Idontwanastudy/-stm32-MP3-FLAC-WAV-/Hardware/hifimp3 BOM/BOM_主板_PCB1_2026-09-06.xlsx

No. | Quantity | Comment | Designator | Footprint | Value | Manufacturer Part | Manufacturer | Supplier Part | Supplier
1 | 2 | 100nF | C10,C17 | C0603 |  | CC0603KRX7R9BB104 | YAGEO | C14663 | LCSC
2 | 1 | 8.2nF | C12 | C0603 |  | CL10B822KB8NNNC | SAMSUNG | C27920 | LCSC
3 | 1 | 1.2nF | C14 | C0603 |  | FN18X122K500PSG | PSA(Prosperity Dielectrics) | C565591 | LCSC
4 | 1 | 10pF | C15 | C0603 |  | CC0603JRNPO9BN100 | YAGEO | C106245 | LCSC
5 | 2 | 100nF | C24,C26 | C0805__ |  | CC0603KRX7R9BB104 | YAGEO | C14663 | LCSC
6 | 2 | 22uF | C27,C28 | C0805__ |  | CL10A226MQ8NRNC | SAMSUNG | C59461 | LCSC
7 | 2 | 47uF | C38,C39 | C0805 | 47uF | CGA0805X5R476M100MT | HRE(芯声) | C6119904 | LCSC
8 | 2 | 4.7uF | C40,C41 | C0805 | 4.7uF | CGA0805X7R475K350MT | HRE(芯声) | C6119943 | LCSC
9 | 6 | 100nF | C44,C45,C77,C92,C100,C101 | C0603 | 100nF | FCC0603B104K500CT | FOJAN(富捷) | C5137636 | LCSC
10 | 2 | 5.6pF | C46,C53 | C0603 | 5.6pF | CC0603CRNPO9BN5R6 | YAGEO(国巨) | C309464 | LCSC
11 | 2 | 220nF | C52,C65 | C0603 | 220nF | CC0603KRX7R9BB224 | YAGEO(国巨) | C107083 | LCSC
12 | 1 | 10nF | C54 | C0603 | 10nF | FCC0603B103K500CT | FOJAN(富捷) | C5137477 | LCSC
13 | 1 | 4.7nF | C55 | C0603 | 4.7nF | 0603B472K500NT | FH(风华) | C53987 | LCSC
14 | 10 | 10uF | C61,C62,C63,C64,C67,C78,C79,C93,C94,C95 | C0805 | 10uF | CGA0805X5R106K500MT | HRE(芯声) | C6119889 | LCSC
15 | 1 | 1.5nF | C66 | C0603 | 1.5nF | CC0603KRX7R9BB152 | YAGEO(国巨) | C96090 | LCSC
16 | 8 | 4.7uF | C80,C81,C82,C83,C84,C85,C86,C87 | C1206 | 4.7uF | HHV1206R7475K101NSPJ | Chinocera(华瓷) | C22367839 | LCSC
17 | 2 | 100nF | C88,C89 | C0805 | 100nF | CC0805KRX7R9BB104 | YAGEO(国巨) | C49678 | LCSC
18 | 2 | 4.7uF | C90,C91 | C0805 | 4.7uF | HGC0805R7475K500NSLJ | Chinocera(华瓷) | C7472970 | LCSC
19 | 2 | 47uF | C96,C97 | CAP-SMD_BD6.3-L6.6-W6.6-LS7.3-FD | 47uF | MA35V47M6X6 | JIERR(捷而瑞) | C46550468 | LCSC
20 | 2 | 220pF | C98,C99 | C0603 | 220pF | CC0603JRNPO9BN221 | YAGEO(国巨) | C106210 | LCSC
21 | 1 | LAIL-PHC2.54-3P-01-XH-RT | CN1 | CONN-TH_3P-P2.50_XY-XHB2.54-3A21-R |  | LAIL-PHC2.54-3P-01-XH-RT | 莱联 | C54905897 | LCSC
22 | 1 | PJ-313D | CN2 | AUDIO-SMD_PJ-313D-2 |  | PJ-313D | SHOU HAN(首韩) | C668608 | LCSC
23 | 1 | LAIL-SI-2.54-2X6P-ZC | CN3 | IDC-TH_12P-P2.54-V-M-R2-C6-LS2.54 |  | LAIL-SI-2.54-2X6P-ZC | LAILAN(莱联) | C55118371 | LCSC
24 | 1 | SS36 | D2 | SMA_L4.3-W2.6-LS5.0-FD |  | SS36 | 宏嘉诚 | C7420367 | LCSC
25 | 5 | SS52B | D3,D4,D5,D6,D7 | SMB_L4.6-W3.6-LS5.3-RD |  | SS52B | R+O(宏嘉诚) | C41410781 | LCSC
26 | 1 | DC-005-A200 | DC1 | DC-IN-TH_DC-005-A200 |  | DC-005-A200 | XUNPU(讯普) | C720557 | LCSC
27 | 2 | LAIL-PZ2.54-3P-L | H1,H2 | HDR-TH_3P-P2.54-V-M-1 |  | LAIL-PZ2.54-3P-L | LAILAN(莱联) | C54950604 | LCSC
28 | 3 | LAIL-PZ2.54-1P-L | H3,H4,H5 | HDR-TH_LAIL-PZ2.54-1P-L |  | LAIL-PZ2.54-1P-L | 莱联 | C54950614 | LCSC
29 | 1 | LAIL-PZ2.54-4PX2-L | H6 | HDR-TH_LAIL-PZ2.54-4PX2-L |  | LAIL-PZ2.54-4PX2-L | 莱联 | C54950608 | LCSC
30 | 1 | LAIL-PZ2.54-2PX2-L | H7 | HDR-TH_LAIL-PZ2.54-2PX2-L |  | LAIL-PZ2.54-2PX2-L | 莱联 | C54950613 | LCSC
31 | 1 | I2S_DEC | H8 | CONN-TH_LAIL-PZ2.54-4P-L |  | I2S_DEC | 莱联 | C54950602 | LCSC
32 | 1 | SPI1_DEC | H9 | CONN-TH_LAIL-PZ2.54-4P-L |  | SPI1_DEC | 莱联 | C54950602 | LCSC
33 | 1 | 6.8uH | L1 | IND-SMD_L5.0-W5.0_SWPA5040S |  | SWPA5040S6R8M | Sunlord | C36411 | LCSC
34 | 2 | 4.7uH | L2,L3 | IND-SMD_L5.4-W5.2_FXL0530 | 4.7uH | FXL0530-4R7-M | cjiang(长江微电) | C177246 | LCSC
35 | 2 | 10uH | L4,L5 | L1206 | 10uH | CMI321609X100KT | FH(风华) | C1051 | LCSC
36 | 1 | 17-21SUYC/TR8 | LED1 | LED0805-RD |  | 17-21SUYC/TR8 | KENTO | C2296 | LCSC
37 | 1 | LTST-C190KSKT GREEN | LED2 | LED0603-RD |  | LTST-C190KSKT GREEN | LITEON(光宝) | C125095 | LCSC
38 | 1 | LTST-C190KSKT RED | LED3 | LED0603-RD |  | LTST-C190KSKT RED | LITEON(光宝) | C125095 | LCSC
39 | 2 | LTST-C190KSKT BLUE | LED4,LED5 | LED0603-RD |  | LTST-C190KSKT BLUE | LITEON(光宝) | C125095 | LCSC
40 | 1 | SI2323DS | Q1 | SOT-23-3_L2.9-W1.3-P1.90-LS2.4-BR |  | SI2323DS | TECH PUBLIC(台舟) | C5182044 | LCSC
41 | 1 | 1K | R3 | R0805 |  | 0805W8F1001T5E | UniOhm | C17513 | LCSC
42 | 1 | 330K | R4 | R0603 |  | 0603WAF3303T5E | UniOhm | C23137 | LCSC
43 | 1 | 68K | R5 | R0603 |  | 0603WAF6802T5E | UniOhm | C23231 | LCSC
44 | 1 | 30K | R6 | R0603 |  | 0603WAF3002T5E | UniOhm | C22984 | LCSC
45 | 1 | 10K | R9 | R0603 |  | 0603WAF1002T5E | UniOhm | C25804 | LCSC
46 | 1 | 1.87K/1.91k | R10 | R0603 |  | 0603WAF1871T5E | UniOhm | C22850 | LCSC
47 | 1 | 100Ω | R11 | R0603 | 100Ω | FRC0603F1000TS | FOJAN(富捷) | C2906981 | LCSC
48 | 13 | 0Ω | R15,R16,R17,R18,R19,R20,R25,R28,R29,R30,R40,R54,R55 | R1206 | 0Ω | RE1206F1R000 | JIERR(捷而瑞) | C46961765 | LCSC
49 | 2 | 130kΩ | R21,R26 | R0603 | 130kΩ | FRC0603F1003TS | FOJAN(富捷) |  | LCSC
50 | 1 | 1MΩ | R23 | R0603 | 1MΩ | FRC0603F1004TS | FOJAN(富捷) | C2907003 | LCSC
51 | 1 | 150kΩ | R24 | R0603 | 150kΩ | FRC0603F1004TS | FOJAN(富捷) |  | LCSC
52 | 1 | 1.3MΩ | R27 | R0603 | 1.3MΩ | FRC0603F1004TS | FOJAN(富捷) |  | LCSC
53 | 3 | 100kΩ | R31,R32,R33 | R0603 | 100kΩ | FRC0603F1003TS | FOJAN(富捷) | C2906980 | LCSC
54 | 4 | 1.5kΩ | R34,R35,R36,R37 | R0603 | 1.5kΩ | FRC0603F1501TS | FOJAN(富捷) | C2930050 | LCSC
55 | 1 | 1kΩ | R38 | R0603 | 1kΩ | FRC0603F1001TS | FOJAN(富捷) | C2907002 | LCSC
56 | 3 | 10kΩ | R39,R56,R57 | R0603 | 10kΩ | FRC0603J103 TS | FOJAN(富捷) | C2930027 | LCSC
57 | 1 | 22.6kΩ | R41 | R0603 | 22.6kΩ | RT0603BRD0722K6L | YAGEO(国巨) | C861236 | LCSC
58 | 1 | 30.1kΩ | R42 | R0603 | 30.1kΩ | RC0603FR-0730K1L | YAGEO(国巨) | C137745 | LCSC
59 | 2 | HC-PM254-8.5H-2x29PZ | U1,U2 | HDR-TH_58P-P2.54-V-F-R2-C29-S2.54_HC-PM254-8.5H-2X29PZ |  | HC-PM254-8.5H-2x29PZ | HC(虹成电子) | C41376169 | LCSC
60 | 1 | AMS1117-3.3 | U10 | SOT-223-3_L6.5-W3.4-P2.30-LS7.0-BR |  | AMS1117-3.3 | AMS | C6186 | LCSC
61 | 1 | TPS54331DDAR | U14 | SOIC-8_L4.9-W3.9-P1.27-LS6.0-BL-EP |  | TPS54331DDAR | TI(德州仪器) | C90761 | LCSC
62 | 1 | TPS65131RGER | U15 | QFN-24_L4.0-W4.0-P0.50-TL-EP2.6 |  | TPS65131RGER | TI(德州仪器) | C87663 | LCSC
63 | 1 | BQ24032ARHLT | U16 | VQFN-20_L4.5-W3.5-P0.50-BL-EP_TI_RHL0020A |  | BQ24032ARHLT | TI(德州仪器) | C2868271 | LCSC
64 | 1 | WM8960CGEFL/RV | U17 | QFN-32_L5.0-W5.0-P0.50-TL-EP |  | WM8960CGEFL/RV | Cirrus Logic(凌云) | C18752 | LCSC
65 | 1 | LAIL-PM2.54-9PX2-L | U18 | HDR-TH_18P-P2.54-V-F-R2-C9-S2.54-3 |  | LAIL-PM2.54-9PX2-L | 莱联 | C54973852 | LCSC
66 | 1 | W25Q64JVSSIQ | U19 | SOIC-8_L5.3-W5.3-P1.27-LS8.0-BL |  | W25Q64JVSSIQ | Winbond(华邦) | C179171 | LCSC
67 | 1 | LAIL-PM2.54-4PX2-L | U20 | HDR-TH_8P-P2.54-V-F-R2-C4-S2.54-1 |  | LAIL-PM2.54-4PX2-L | 莱联 | C54973831 | LCSC
68 | 1 | I2C_SCREEN | U21 | HDR-TH_8P-P2.54-V-F-R2-C4-S2.54-1 |  | I2C_SCREEN | 莱联 | C54973831 | LCSC
69 | 1 | 50kΩ | U22 | RES-ADJ-SMD_RM065-V1 | 50kΩ | RM065-503(50K) | BOCHEN(博晨) | C5205023 | LCSC
70 | 1 | 20kΩ | U23 | RES-ADJ-SMD_RM065-V1 | 20kΩ | RM065-203(20K) | BOCHEN(博晨) | C5205022 | LCSC
71 | 2 | HX-XH2.54-2PZZ | 右喇叭,左喇叭 | CONN-TH_2P-P2.50_HX-2.54MM-2P-ZZ-MS |  | HX-XH2.54-2PZZ | hanxia(韩下) | C42391660 | LCSC
