Idontwanastudy/-stm32-MP3-FLAC-WAV-/Hardware/hifimp3 BOM/BOM_功放板_PCB3_2026-09-06.xlsx

No. | Quantity | Comment | Designator | Footprint | Value | Manufacturer Part | Manufacturer | Supplier Part | Supplier
1 | 2 | 4.7uF | C1,C15 | C0805 | 4.7uF | HGC0805R7475K500NSLJ | Chinocera(华瓷) | C7472970 | LCSC
2 | 6 | 15pF | C2,C9,C10,C16,C23,C24 | C0603 | 15pF | FCC0603N150J500CT | FOJAN(富捷) | C5137617 | LCSC
3 | 12 | 100nF | C3,C4,C7,C8,C11,C12,C17,C18,C21,C22,C25,C26 | C0603 | 100nF | FCC0603B104K500CT | FOJAN(富捷) | C5137636 | LCSC
4 | 4 | 47uF | C5,C6,C19,C20 | CAP-SMD_BD5.0-L5.3-W5.3-LS5.9-FD | 47uF | JVJ25V47M5x5 | JIERR(捷而瑞) | C46550408 | LCSC
5 | 4 | 470uF | C27,C28,C29,C30 | CAP-SMD_BD6.3-L6.6-W6.6-LS7.3-FD-H7.7 | 470uF | JVJ16V470M6x8 | JIERR(捷而瑞) | C46550400 | LCSC
6 | 8 | 1N4148W | D1,D2,D3,D4,D5,D6,D7,D8 | SOD-123_L2.7-W1.6-LS3.7-FD |  | 1N4148W | R+O(宏嘉诚) | C7420318 | LCSC
7 | 1 | PZ254V-12-18P | H1 | HDR-TH_18P-P2.54-V-M-R2-C9-S2.54 |  | PZ254V-12-18P | XFCN(兴飞) | C492426 | LCSC
8 | 1 | PZ254V-12-8P | H2 | HDR-TH_8P-P2.54-V-M-R2-C4-S2.54 |  | PZ254V-12-8P | XFCN(兴飞) | C492421 | LCSC
9 | 2 | 2SD882 | Q1,Q8 | TO-252-2_L6.6-W6.1-P4.58-LS9.9-BR |  | 2SD882 | MSKSEMI(美森科) | C3008134 | LCSC
10 | 2 | 2SB772 | Q2,Q9 | TO-252-2_L6.5-W6.1-P4.58-LS10.0-BL |  | 2SB772 | MSKSEMI(美森科) | C3008133 | LCSC
11 | 2 | BC857C | Q3,Q10 | SOT-23-3_L2.9-W1.3-P1.90-LS2.4-BR |  | BC857C | R+O(宏嘉诚) | C20069137 | LCSC
12 | 4 | BC847C | Q6,Q7,Q11,Q12 | SOT-23-3_L2.9-W1.3-P1.90-LS2.4-BR |  | BC847C | R+O(宏嘉诚) | C7420337 | LCSC
13 | 2 | 100Ω | R1,R18 | R2512 | 100Ω | 3522100RJT | TE Connectivity(泰科电子) | C5495270 | LCSC
14 | 6 | 47kΩ | R2,R3,R5,R19,R20,R22 | R0603 | 47kΩ | FRC0603F4702TS | FOJAN(富捷) | C2907042 | LCSC
15 | 2 | 2.2kΩ | R4,R21 | R0603 | 2.2kΩ | FRC0603F2201TS | FOJAN(富捷) | C2907005 | LCSC
16 | 2 | 2kΩ | R6,R23 | R0603 | 2kΩ | FRC0603F2001TS | FOJAN(富捷) | C2907022 | LCSC
17 | 6 | 18kΩ | R7,R8,R14,R24,R25,R30 | R0603 | 18kΩ | 0603WAF1802T5E | UNI-ROYAL(厚声) | C25810 | LCSC
18 | 4 | 100Ω | R9,R10,R26,R27 | R0805 | 100Ω | 0805W8F1000T5E | UNI-ROYAL(厚声) | C17408 | LCSC
19 | 4 | 10Ω | R15,R16,R31,R32 | R2512 | 10Ω | 3522100RJT | TE Connectivity(泰科电子) |  | LCSC
20 | 2 | 100Ω | R17,R33 | R0805 | 100Ω | FRC0805F1000TS | FOJAN(富捷) | C2907218 | LCSC
21 | 2 | 470Ω | R34,R35 | R0603 | 470Ω | FRC0603J471 TS | FOJAN(富捷) | C2907172 | LCSC
22 | 2 | 1kΩ | R36,R37 | RES-ADJ-TH_3296W-1-203 | 1kΩ | 3296W-1-102 | JIERR(捷而瑞) | C48997938 | LCSC
23 | 1 | 50kΩ | RJ1 | RES-ADJ-TH_RK09712200MY | 50kΩ | RK09712200MC | ALPSALPINE(阿尔卑斯阿尔派) |  | LCSC
24 | 2 | NE5532DR | U1,U3 | SOIC-8_L4.9-W3.9-P1.27-LS6.0-BL |  | NE5532DR | TI(德州仪器) | C7426 | LCSC
