Idontwanastudy/-stm32-MP3-FLAC-WAV-/Hardware/hifimp3 BOM/BOM_按键板_PCB6_2026-09-06.xlsx

No. | Quantity | Comment | Designator | Footprint | Value | Manufacturer Part | Manufacturer | Supplier Part | Supplier
1 | 9 | 100nF | C68,C69,C70,C71,C72,C73,C74,C75,C76 | C0402 | 100nF | CC0402KRX7R7BB104 | YAGEO(国巨) | C60474 | LCSC
2 | 1 | LAIL-SI-2.54-2X6P-ZC | CN1 | IDC-TH_12P-P2.54-V-M-R2-C6-LS2.54 |  | LAIL-SI-2.54-2X6P-ZC | LAILAN(莱联) | C55118371 | LCSC
3 | 2 | 10kΩ | RN1,RN2 | RES-ARRAY-SMD_0402-16P-L4.0-W1.6-BL-2 | 10kΩ | 16P8WGF1002T4E | UNI-ROYAL(厚声) | C422188 | LCSC
4 | 9 | KH-6X6X5H-STM | SW1,SW2,SW3,SW4,SW5,SW6,SW7,SW8,SW9 | SW-SMD_4P-L6.0-W6.0-P4.50-LS9.0_H5.0 |  | KH-6X6X5H-STM | kinghelm(金航标) | C2837531 | LCSC
