Idontwanastudy/-stm32-MP3-FLAC-WAV-/Hardware/图纸/主板.pdf

DCDC 12/24V-5V | L1

# 电源系统

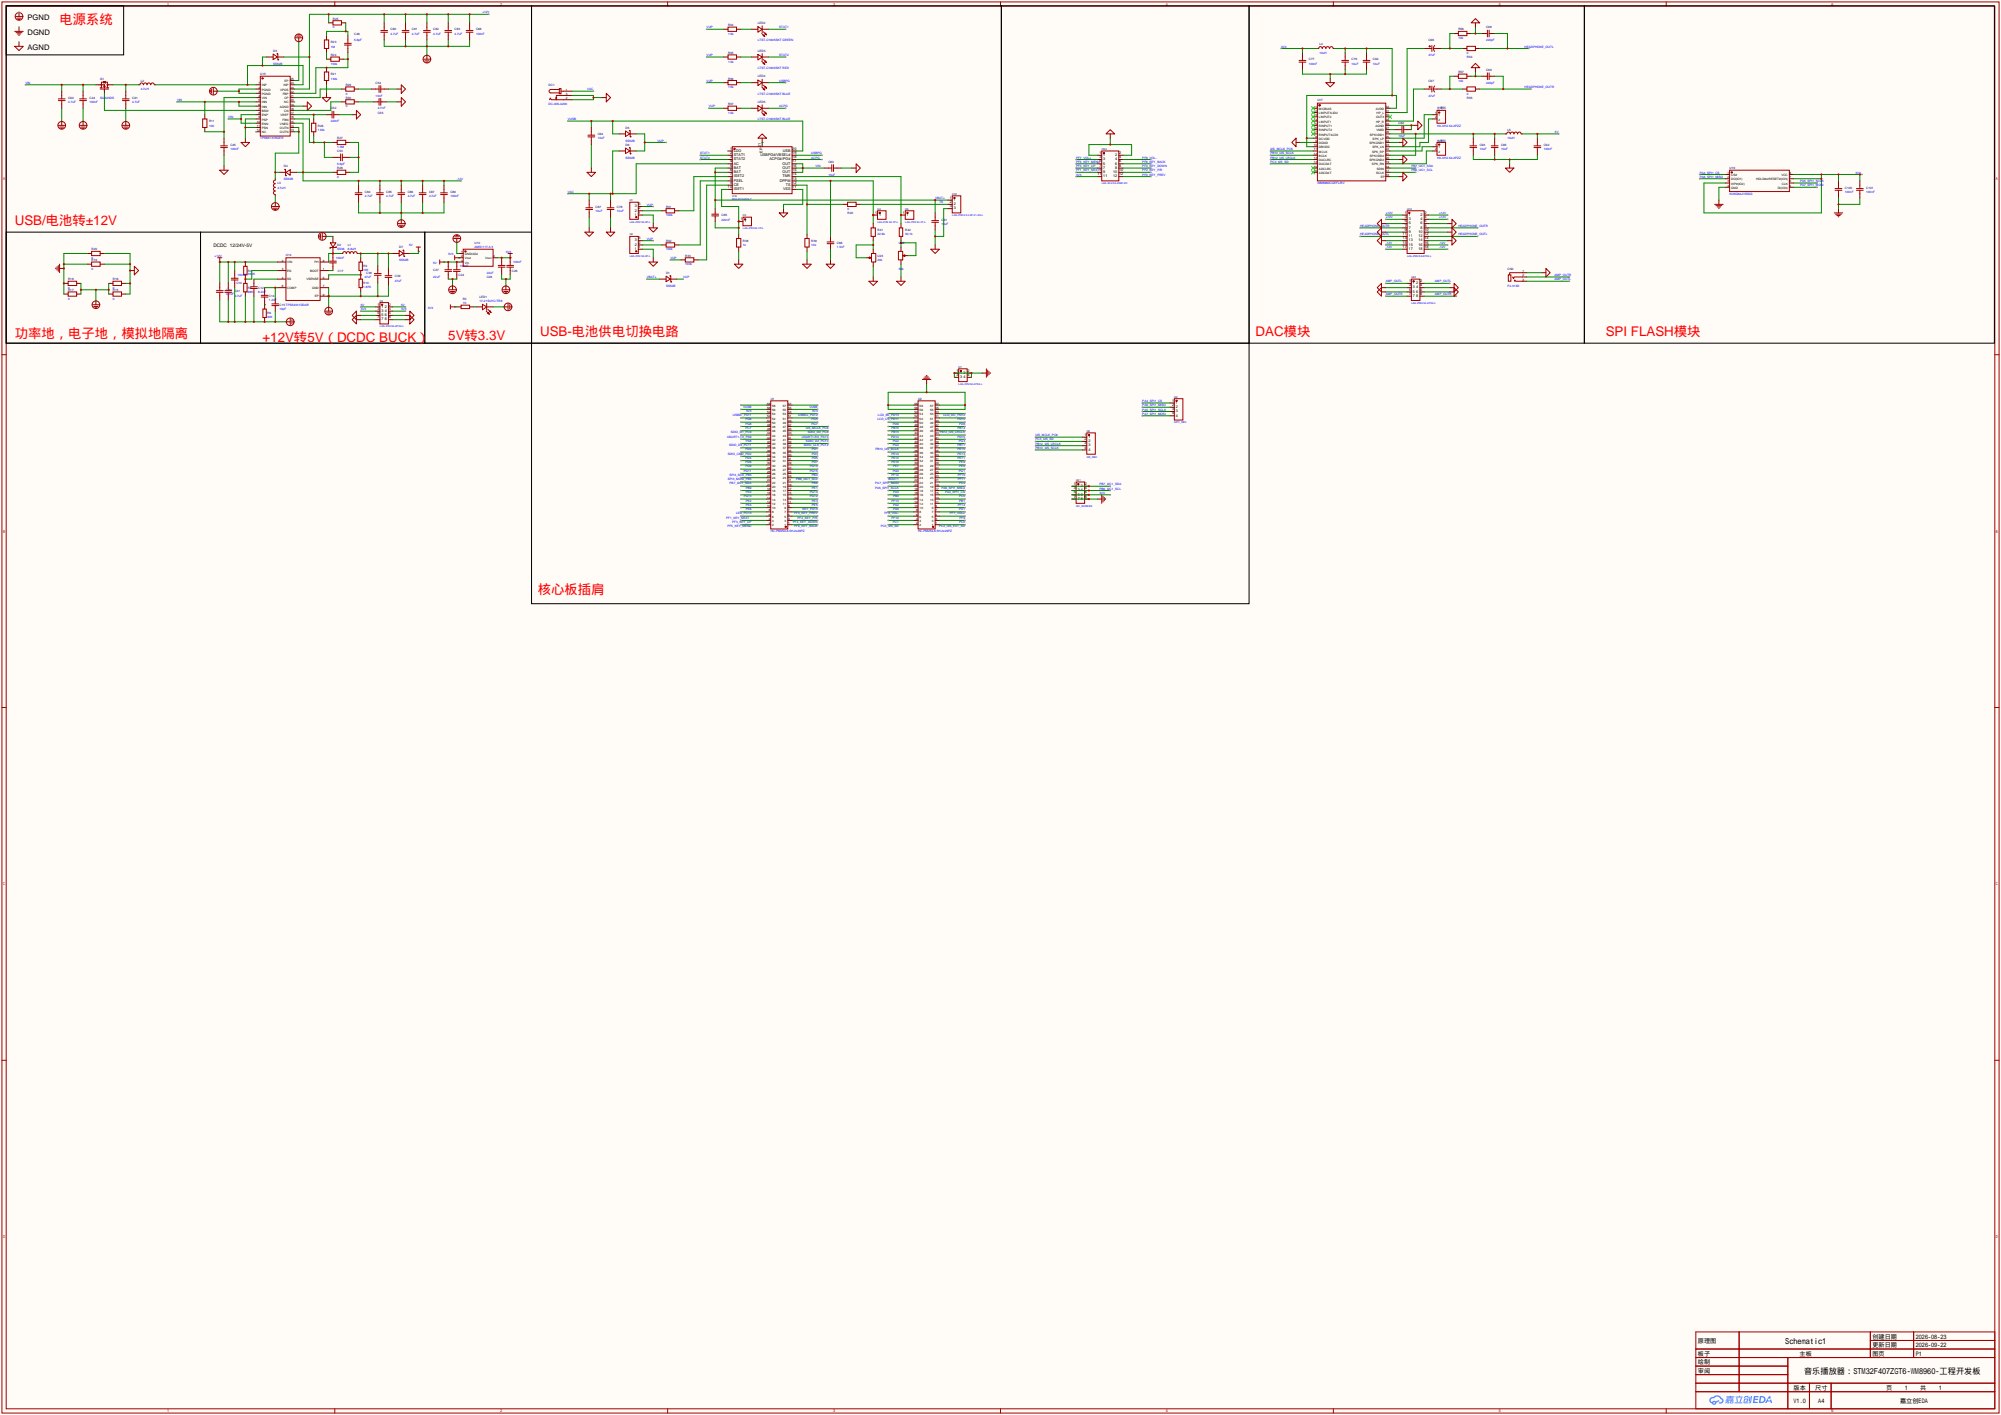
[picture p2: page 1]

原理图 | Schematic1 | 创建日期 | 2026-08-23

更新日期 | 2026-09-22

板子 | 主板 | 图页 | P1
绘制 | | 音乐播放器：STM32F407ZGT6-WM8960-工程开发板
审阅

V1.0 | A4 | 嘉立创EDA
