Idontwanastudy/-stm32-MP3-FLAC-WAV-/Hardware/图纸/功放板.pdf

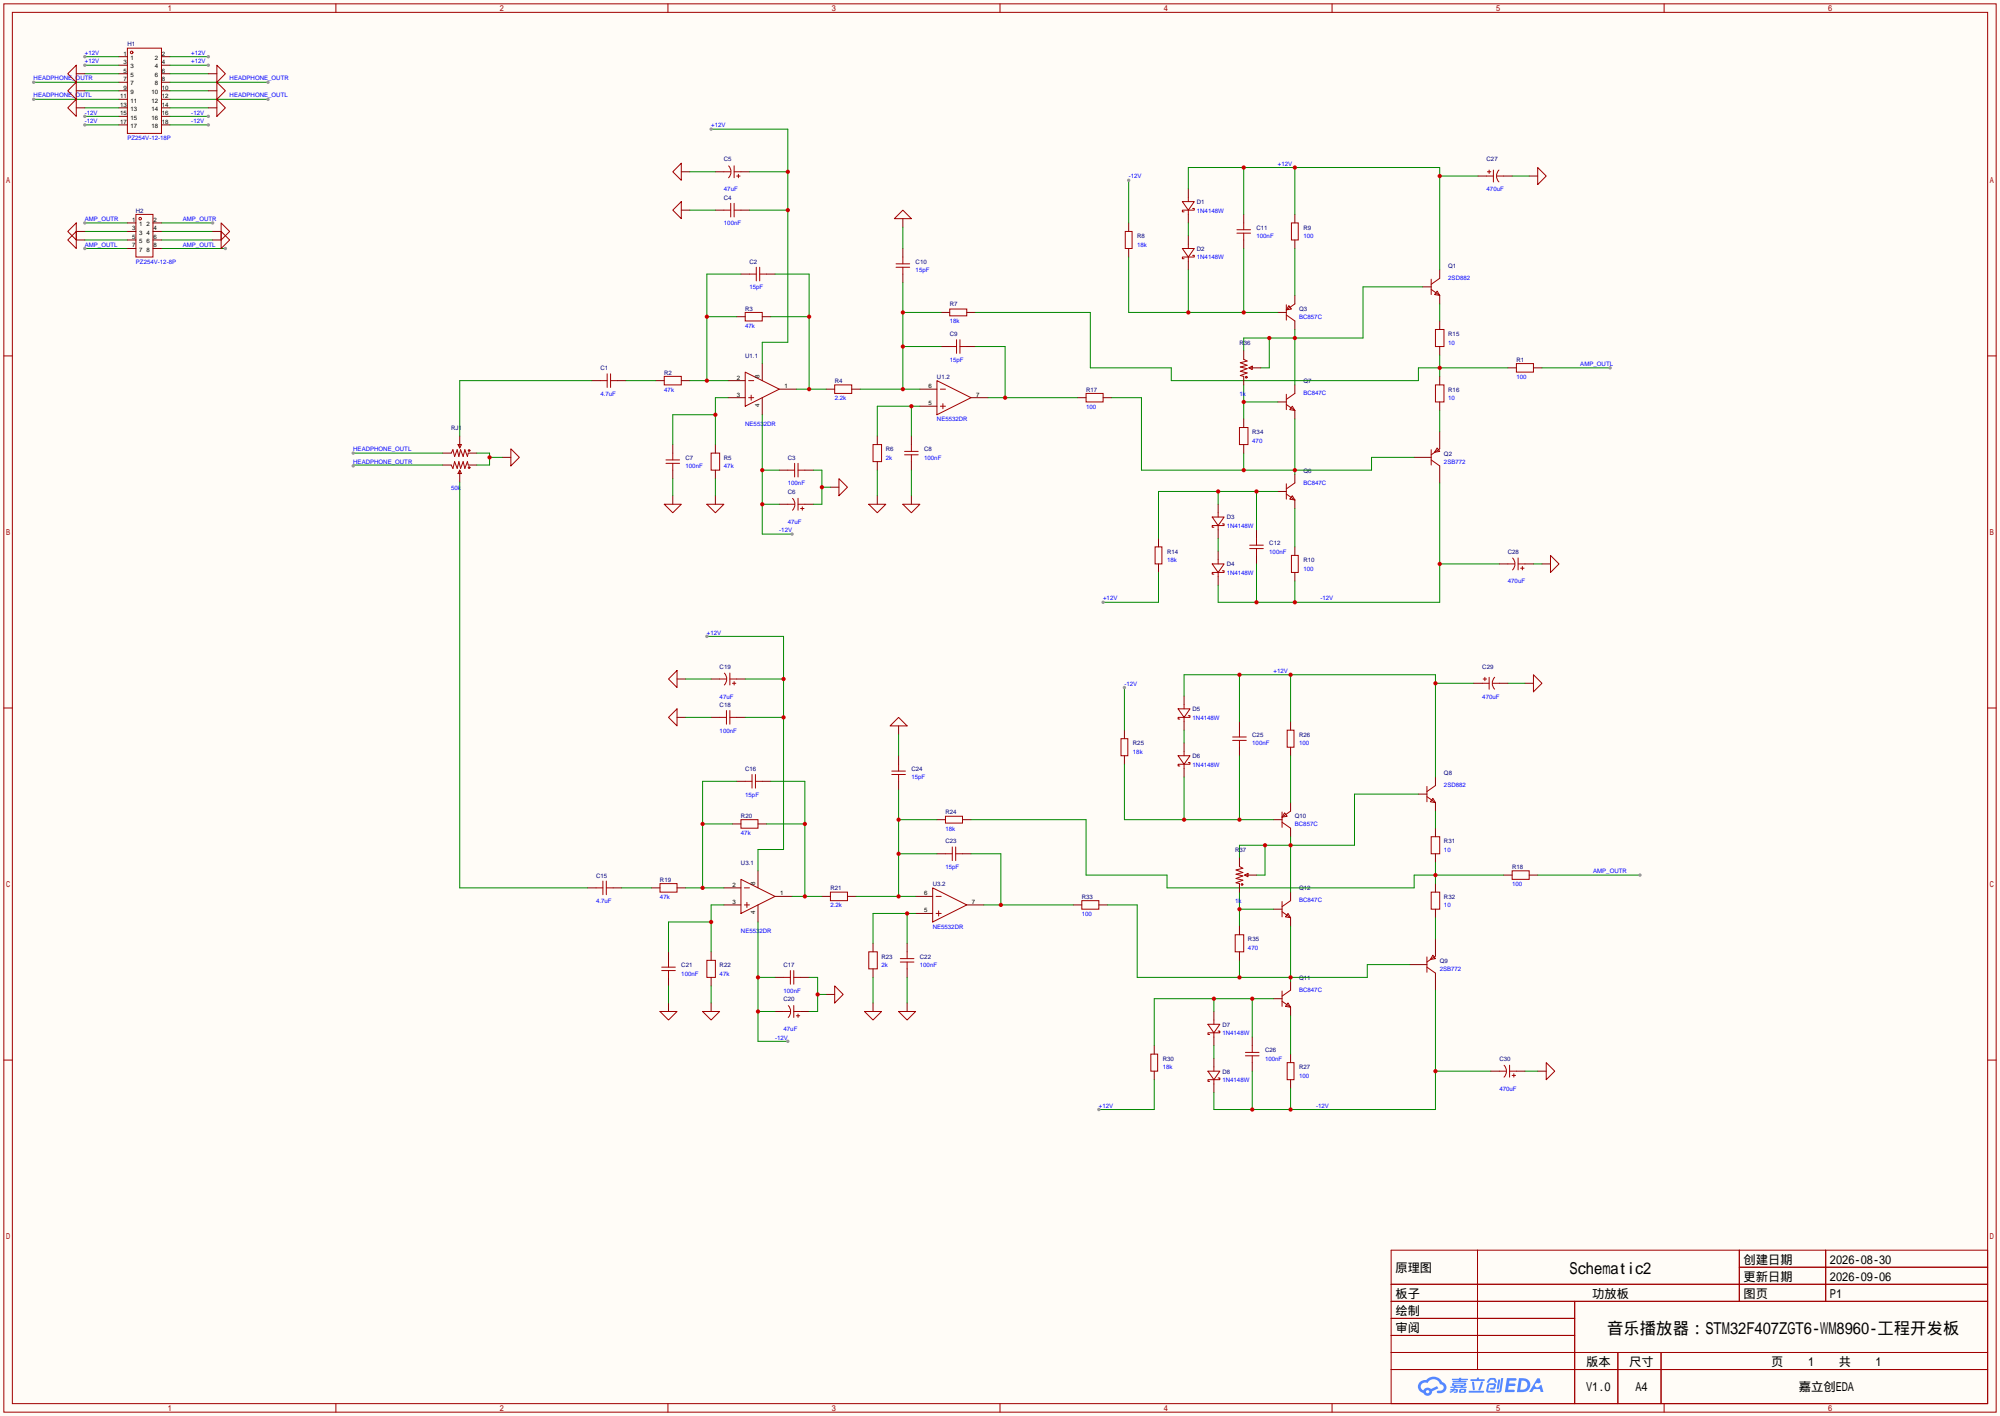
[picture p3: page 1]

原理图 | Schematic2 | 创建日期 | 2026-08-30

更新日期 | 2026-09-06

板子 | 功放板 | 图页 | P1
绘制 | | 音乐播放器：STM32F407ZGT6-WM8960-工程开发板
审阅

V1.0 | A4 | 嘉立创EDA
