Idontwanastudy/-stm32-MP3-FLAC-WAV-/Core/Src/main.c

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
/* Includes ------------------------------------------------------------------*/
#include "main.h"
#include "cmsis_os.h"
#include "dma.h"
#include "fatfs.h"
#include "i2c.h"
#include "i2s.h"
#include "sdio.h"
#include "spi.h"
#include "usb_device.h"
#include "gpio.h"

/* USER CODE BEGIN Includes */
#include "OLED.h"
#include "wm8960.h"   /* WM8960 CODEC 驱动 (I2C 配置, 不初始化则耳机无声) */
/* USER CODE END Includes */


void SystemClock_Config(void);
void MX_FREERTOS_Init(void);
/* USER CODE BEGIN PFP */
void MX_FREERTOS_Init(void);   /* 任务创建�? freertos.c (本工程无 freertos.h, 这里手动声明) */
/* USER CODE END PFP */

/**
  * @brief  The application entry point.
  * @retval int
  */
int main(void)
{

  /* MCU Configuration--------------------------------------------------------*/

  /* Reset of all peripherals, Initializes the Flash interface and the Systick. */
  HAL_Init();

  /* Configure the system clock */
  SystemClock_Config();

  /* Initialize all configured peripherals */
  MX_GPIO_Init();
  MX_DMA_Init();
  MX_I2C1_Init();
  MX_I2S2_Init();
  MX_SPI1_Init();
  MX_SDIO_SD_Init();
  MX_FATFS_Init();
  /* USER CODE BEGIN 2 */
  OLED_Init();
  OLED_Clear();

  /* 初始化 WM8960 CODEC (I2C1, 器件地址 0x34)。
   * 重要: WM8960 是寄存器控制的 codec, 上电后 DAC/输出驱动/混音器/音量默认全关,
   *       不写这串初始化寄存器 → 耳机没有任何声音。 */
  {
      uint8_t wm_ok = WM8960_Init();
      OLED_ShowString(1, 1, wm_ok ? "WM8960 OK" : "WM8960 ERR");
      OLED_RefreshScreenWithScroll();
      HAL_Delay(500);
  }
  /* USER CODE END 2 */

  /* Init scheduler */
  osKernelInitialize();

  /* Call init function for freertos objects (in cmsis_os2.c) */
  MX_FREERTOS_Init();

  /* Start scheduler */
  osKernelStart();

  /* We should never get here as control is now taken by the scheduler */

  /* Infinite loop */
  /* USER CODE BEGIN WHILE */
  while (1)
  {
    /* USER CODE END WHILE */

    /* USER CODE BEGIN 3 */
  }
  /* USER CODE END 3 */
}

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
