Idontwanastudy/-stm32-MP3-FLAC-WAV-/Music_Player_F407ZGT6.ioc

Mcu.UserName=STM32F407ZGTx
PA11.Signal=USB_OTG_FS_DM
PA12.Signal=USB_OTG_FS_DP
PA15.Signal=SPI1_NSS
PA4.GPIO_Label=W25Q64_CS
PA4.Signal=GPIO_Output
PA5.Signal=SPI1_SCK
PA6.Signal=SPI1_MISO
PA7.Signal=SPI1_MOSI
PA9.Signal=USB_OTG_FS_VBUS
PB10.Signal=I2S2_CK
PB12.Signal=I2S2_WS
PB6.Signal=I2C1_SCL
PB7.Signal=I2C1_SDA
PC10.Signal=SDIO_D2
PC11.Signal=SDIO_D3
PC12.Signal=SDIO_CK
PC2.Signal=I2S2_ext_SD
PC3.Signal=I2S2_SD
PC6.Signal=I2S2_MCK
PC8.Signal=SDIO_D0
PC9.Signal=SDIO_D1
PD2.Signal=SDIO_CMD
PF0.Signal=GPXTI0
PF1.Signal=GPXTI1
PF2.Signal=GPXTI2
PF3.Signal=GPXTI3
PF4.Signal=GPXTI4
PF5.Signal=GPXTI5
PF6.Signal=GPIO_Input
PF7.Signal=GPIO_Input
PF8.Signal=GPIO_Input
PH0-OSC_IN.Signal=RCC_OSC_IN
PH1-OSC_OUT.Signal=RCC_OSC_OUT
