Idontwanastudy/-stm32-MP3-FLAC-WAV-/Core/Src/ff_unicode.c

/*
 * ff_unicode.c - FatFs 的 cp936(GBK) <-> Unicode 转换表  ★本文件由 tools/gen_ff_unicode.py 生成, 勿手改★
 *
 * 用途: _LFN_UNICODE=0 时, FatFs 用 ff_convert() 在 OEM(本工程 = cp936/GBK)与 Unicode 之间转换,
 *       列目录和打开文件都要用它。原来那份只覆盖 GB2312 汉字, 导致**俄语/日语/繁体文件名
 *       转换失败 → 打不开 → 显示"文件损坏/跳过"**(假名在 GB2312 第4/5区、西里尔在第7区, 原表那几区是空的)。
 *
 * 本表覆盖完整 cp936: 整个 CJK 基本区(U+4E00~U+9FA5, 简繁日韩汉字都在内) + 假名 + 西里尔 +
 * 希腊 + 全角字符 + 符号。两向都是 O(1) 查表(汉字区用索引数组, 其余二分)。
 *
 * 覆盖统计: GBK→Unicode 21791 项, Unicode→GBK 汉字 20902 项 + 其它 889 项
 */

#include "ff.h"

#define GBK_SLOT_COUNT   23940u   /* 0x81..0xFE 每字节 190 个位置 */
#define HANZI_LO         0x4E00u
#define HANZI_COUNT      20903u
#define SYM_COUNT        889u

/* GBK 双字节码 → 紧凑索引(与 FatFs 官方 cc936 一致) */
static unsigned gbk_index(unsigned gbk)
{
    unsigned hi = (gbk >> 8) & 0xFF, lo = gbk & 0xFF;
    if (hi < 0x81 || hi > 0xFE)  return 0xFFFFFFFFu;
    if (lo < 0x40 || lo > 0xFE || lo == 0x7F) return 0xFFFFFFFFu;
    if (lo > 0x7E) lo--;
    return (hi - 0x81) * 190u + (lo - 0x40);
}

/* GBK(紧凑索引) → Unicode; 0 = 该位置没有字符 */
static const WCHAR g2u_tbl[GBK_SLOT_COUNT] = {
  0x4E02, 0x4E04, 0x4E05, 0x4E06, 0x4E0F, 0x4E12, 0x4E17, 0x4E1F,
  0x4E20, 0x4E21, 0x4E23, 0x4E26, 0x4E29, 0x4E2E, 0x4E2F, 0x4E31,
  0x4E33, 0x4E35, 0x4E37, 0x4E3C, 0x4E40, 0x4E41, 0x4E42, 0x4E44,
  0x4E46, 0x4E4A, 0x4E51, 0x4E55, 0x4E57, 0x4E5A, 0x4E5B, 0x4E62,
  0x4E63, 0x4E64, 0x4E65, 0x4E67, 0x4E68, 0x4E6A, 0x4E6B, 0x4E6C,
  0x4E6D, 0x4E6E, 0x4E6F, 0x4E72, 0x4E74, 0x4E75, 0x4E76, 0x4E77,
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
    }
}

/* FatFs 大小写不敏感比较用: 只需处理 ASCII/Latin-1 */
WCHAR ff_wtoupper(WCHAR chr)
{
    if (chr >= 'a' && chr <= 'z') return (WCHAR)(chr - 0x20);
    if (chr >= 0xE0 && chr <= 0xFE && chr != 0xF7) return (WCHAR)(chr - 0x20);
    return chr;
}
