Idontwanastudy/-stm32-MP3-FLAC-WAV-/(commit log)

2026-09-22 v1.0: WAV/FLAC/MP3 三种格式完整播放
    - 按 WM8960 数据手册修复切歌'滋滋'瞬态(停 MCLK 前软静音 + 关 DAC + 等≥1ms, R28 HPSTBY 兜底)
    - 回退会导致'整首纯噪声'的 I2S 相位改动, 恢复'关外设再开'的相位对齐流程
    - 按键加固: 电平确认 + 上电宽限, 修掉'按音量键概率停歌'与'一上电跳过第一首歌'
    - SD 卡热插拔完善(Stat/BusWide/SD_TIMEOUT)
    - MP3 换 Helix 定点解码器, 内存优化释放约 24KB SRAM
    - 清理全部排错诊断代码; 新增 README 与 .gitignore; 修正 .ioc 里遗留的前导空格
    [Music_Driver.c, Music_Driver.h, Music_Player_F407ZGT6.ioc, OLED.c, OLED.h]
2026-09-22 docs: 补充发布记录(已推送 main / F103 保留在 V1.0-F103Ver / 一次性部署密钥)
2026-09-22 add: 硬件资料(立创EDA工程/GERBER/BOM/原理图) + README·开发记录更新
    - Hardware/: 工程 eprj2、GERBER 三个 zip、BOM 三个 xlsx、原理图三个 PDF、_backup 自动快照
    - README: 目录结构补充 Hardware/, 硬件连接处加硬件资料指引
    - 开发记录: 补充发布与硬件资料记录
    [BOM_主板_PCB1_2026-09-06.xlsx, BOM_功放板_PCB3_2026-09-06.xlsx, BOM_按键板_PCB6_2026-09-06.xlsx]
2026-09-22 feat: 多语言文字库(简/繁/日/英/韩/俄)搬到 W25Q64
    - tools/gen_font.py: TTF → 16x16 点阵字库 bin(按 Unicode 区段组织, 无索引表; 带 CRC32)
    支持 --selftest(几何图案自检, 不需要字体文件) / --preview(终端预览点阵) / --px --y-off 调参
    - font_format.c/h: 纯逻辑(解析/区段查表/96槽 LRU 字形缓存), 不依赖 HAL → 可在 PC 上单元测试
    - font_store.c/h: W25Q64 读字库 + 从 SD 卡 font16.bin 烧写(擦除→写→回读 CRC 校验), 全程不用 f_lseek
    - OLED.c: 字符串显示与滚动缓冲统一走新引擎(UTF-8 解码扩到 1~3 字节, 4 字节跳过)
    三级回退: 内 flash 8x16(ASCII) → W25Q64 字库 → 内 flash G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
2026-09-22 docs: F103 分支名更正为 V0.0-F103Ver
2026-09-22 fix(font): 字库垂直定位改用'基线对齐'并实测标定各段字号
    - 原来用 anchor='lt'(墨迹顶部)对齐 → 像 '一' 这种矮字会被顶到最上面(预览发现)
    改为 anchor='ls'(基线)对齐, 所有字共享同一条基线
    - 用测量脚本实测各段墨迹范围, 定出: 汉字/假名/谚文 15px@基线14, 俄文 13px@基线13,
    全角 12px@基线13, 西文补充 12px@基线12 (原值会让俄文下伸字母 у/р 被切)
    - CJK 标点拆成 3 段, 排除 U+302A~302D/U+3031~3035 这些'比 em 还高两倍'的冷僻字符
    (它们会让整段可用字号被迫压到 10px)
    - 实测: Noto Sans CJK SC Regular → 33003 字形 / 1.01MB / CRC32 0x2655BDA7, 宿主机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
2026-09-22 fix(font): 修字库检查时黑屏 —— defaultTask 栈只有 512B 导致栈溢出
    - 现象: 开机显示'字库检查中...'之后黑屏
    - 根因: 字库流程(sprintf + FatFs f_open/f_read + OLED 取字引擎)挂在 defaultTask 里,
    而该任务栈只有 128*4 = 512 字节 → 栈溢出静默踩坏相邻内存; 且 configCHECK_FOR_STACK_OVERFLOW
    没开, 溢出没有任何提示 → 表现就是'画完一句话黑屏'
    - 修: ① 字库检查/烧写挪到 FILE_LOAD 任务(3KB 栈); ② defaultTask 栈 512B→1KB
    ③ 打开 configCHECK_FOR_STACK_OVERFLOW=2 并实现 vApplicationStackOverflowHook(把出问题的任务名显示到屏上)
    ④ AUDIO_READ 改为等扫描完成后再清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
2026-09-22 docs: 记录'任务栈溢出导致开机黑屏'这个坑(含排查与复用提示)
2026-09-22 fix: 俄语/日语文件名显示'文件损坏,跳过' —— GB2312 表只填了汉字
    - 根因: ff_unicode.c 的 ff_convert() 基于 GB2312 区位码表, 而该表 1~9 区(全角/平假名/片假名/
    希腊/西里尔俄文)全是 0, 只填了 16~87 区的汉字。于是俄语(西里尔在第7区)和日语假名(第4/5区)
    的文件名转换失败 → FatFs 用 '?' 代替 → f_open 找不到文件 → 报'文件损坏/跳过'。
    中文歌名一直正常, 正因为汉字在表里, 所以这个坑一直没暴露。
    - 修: ① ff_unicode.c 换成完整的 cp936 表(工具 tools/gen_ff_unicode.py 用 Python cp936 生成):
    GBK→Unicode 21791 项 + Unicode→GBK 汉字 20902 项/其它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
    [Music_Driver.c, OLED.c, ff_unicode.c]
2026-09-22 docs: 记录'多语言文件名打不开'的根因与排查方法(OEM 转换表只填了汉字)
2026-09-22 fix(mp3): 修'能播但声音不对' —— 封面图里的伪同步字被当成音频帧
    根因(宿主机已复现): ID3v2 内嵌封面的 JPEG 标记字节 FFE0~FFEF 与 MP3 同步字 0xFFEx 同形。
    一旦'跳过 ID3 标签'有闪失(读卡偶发错让跳过循环 break, 位置停在标签中间), 解码器就锁到
    伪同步字上; 而 mp3_hz/mp3_channels 是从'解出的第一帧'取的 → 被记成 16kHz/单声道 →
    重采样步进与声道解析全错 = 声音不对。WAV/FLAC 靠解析文件头定位, 所以不受影响。
    实测(Queen - Bohemian Rhapsody.mp3, ID3 标签 504.7KB):
    修复前: 从标签内开始 → 576样本/声道, 1声道, 16000Hz → 1.3万帧垃圾
    修复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
    [Music_Driver.c]
2026-09-22 perf: 开机不再检查/烧写字库(拖慢启动) —— 改成按住 PF7 开机才走 SD 更新流程
    - 常规启动只 font_store_init() 从 W25Q64 读已烧好的字库, 完全不碰 SD
    - 需要更新字库时: font16.bin 放 SD 根目录 + 开机按住 PF7(音量+) 不放
    - 同时去掉开机那句'字库就绪'的 1.2 秒停顿
    - README / 开发记录同步
2026-09-23 fix(build): 修掉 MP3「整体变慢 1.3 倍」—— 真凶是两个工程属性, 不在音频代码里
    现象: WAV/FLAC 正常, 唯独 MP3 整体变慢 1.3 倍(30.04s 的曲子要放 39~43s), 但音高正确(440Hz)。
    用「440Hz 正弦 + 每秒一个咔哒」标准测试音量化后: 音高 440.0Hz ✓, 咔哒间隔 1.27s ✗,
    H/F(硬件播过的行数 / 软件产出的行数) = 641/504 = 1.27 = 慢速倍数 ⇒ 样本被重复, 与时钟无关。
    根因(两个都在工程配置上):
    1) .cproject 里 Debug 配置的 Optimization level 为空 ⇒ GCC 默认 -O0 ⇒
    Helix 解码慢 5~7 倍 ⇒ 单次填充 58ms > 一行窗口 46.4ms ⇒ 慢性亏空 ⇒
    环形 I2S DMA 反复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
    [Music_Driver.c, Music_Driver.h]
2026-09-23 chore(font): 重新生成多语言点阵字库 font16.bin
    用 NotoSansCJKsc-Regular.otf 重新生成(六种文字全含):
    9 个区段 / 33003 字形 / 1.01 MB / CRC32 0x2655BDA7
    含: 拉丁补充(8x16) + 西里尔(俄) + CJK/全角标点 + 平假名/片假名(日) +
    谚文音节(韩 349KB) + CJK 汉字(简/繁/日共用 656KB) + 全角字符
    用途: 放到 SD 卡根目录后, 开机时按住 PF7(音量+)不放 → 会自动校验并烧写进 W25Q64。
    已抽样预览验证点阵成形(音 / Ж / 한)。
    注: 本项目 .gitignore 默认不跟踪 font16.bin(它是生成产物), 这次是按用户要求显式提交,
    便于随仓库分发; 若以后不想跟踪, 用 `git rm --cac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
2026-09-23 chore: 撤掉 MP3 填充耗时诊断脚手架, 恢复歌名正常显示
    MP3_FILL_DIAG 诊断已完成使命(-O0 编译 / HSE_VALUE 两个根因已定位并修复),
    按本项目"诊断是临时脚手架, 定性后主动撤掉"的惯例彻底清除:
    * 删除全部诊断代码: mp3_diag_* 变量、mp3_diag_dwt_init、mp3_diag_show、
    oled_show_padded、mp3_fill_timed 包装(调用点回退为直连 mp3_fill_buffer_region)、
    两个 I2S 回调里的统计、freertos.c 里的每秒刷新、Music_Driver.h 的开关与 extern 声明。
    * MP3 播放界面恢复原样: 第 1 行回到歌名滚动(不再被诊断标题占用),
    第 3/4 行回到 声道 / 位深。
    * configTIMER_TASK_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
    [Music_Driver.c, Music_Driver.h]
2026-09-23 docs: 记录'诊断脚手架已撤除'与脚手架取回位置(提交 258a80d)
